arthurkowskii/AMEN_MINI/hardware/models/TeensyAudioBoard.step

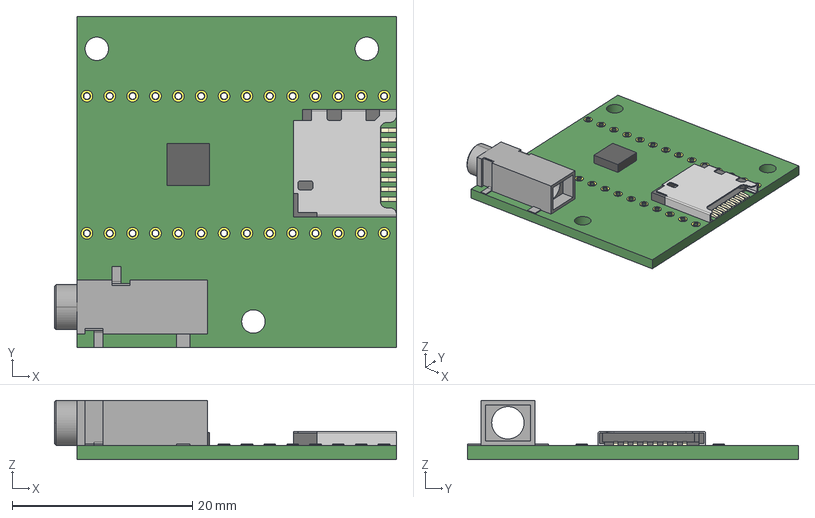
[picture p6: CAD file, 2026-08-08]
hardware/models/TeensyAudioBoard.step
38.0 x 36.8 x 6.60 mm
CUI_DEVICES_SJ-3523-SMT-TR
Base
Case
