arthurkowskii/AMEN_MINI/output/pcb-renders/AMEN_MINI-assembled-concept.png

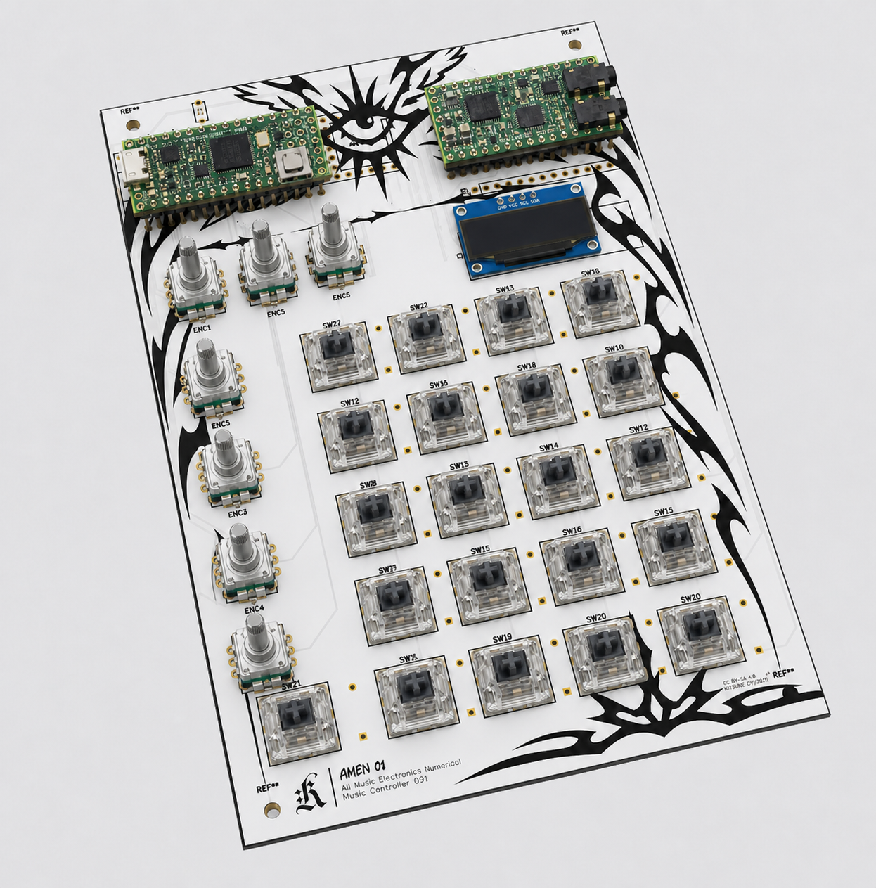
output/pcb-renders/AMEN_MINI-assembled-concept.png
