arthurkowskii/AMEN_MINI/hardware/AMEN_MINI.kicad_pcb

## KiCad design hardware/AMEN_MINI.kicad_pcb (2026-08-09)

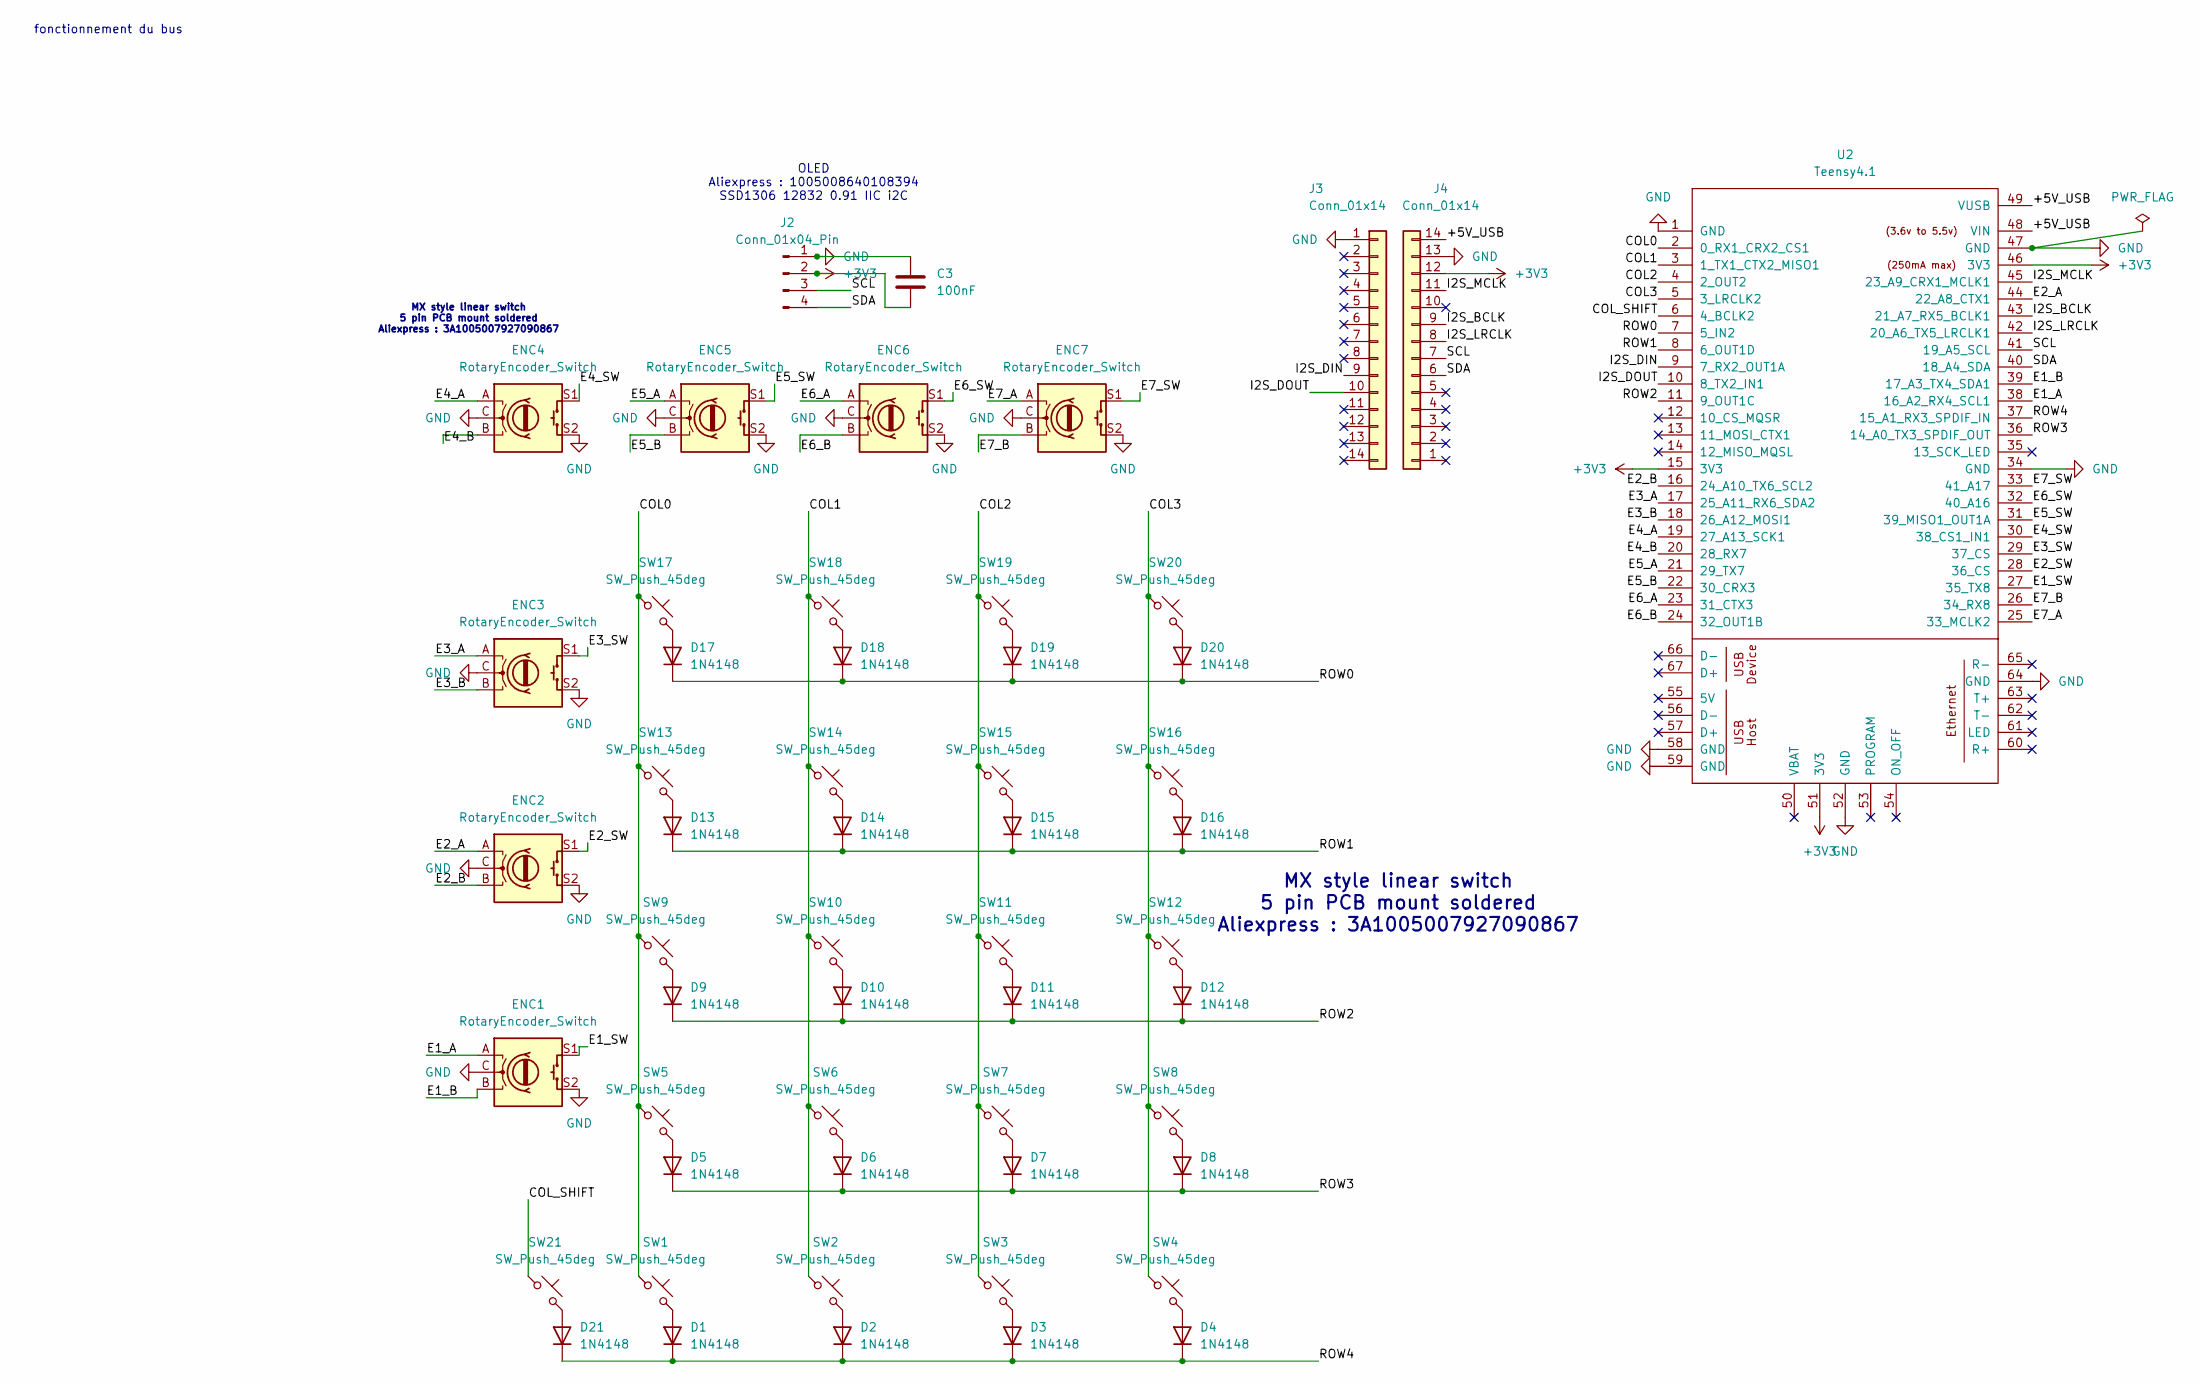
[picture p8: schematic AMEN_MINI.kicad_sch, AKOR_01_SCH]

Parts:
C3: 100nF; C_Disc_D5.0mm_W2.5mm_P5.00mm
D1, D2, D3, D4, D5, D6, D7, D8, D9, D10, D11, D12, D13, D14, D15, D16, D17, D18, D19, D20, D21: 1N4148; D_DO-35_SOD27_P10.16mm_Horizontal
ENC1, ENC2, ENC3, ENC4, ENC5, ENC6, ENC7: RotaryEncoder_Switch; RotaryEncoder_Alps_EC11E-Switch_Vertical_H20mm
J2: Conn_01x04_Pin; ER_OLEDM0.91_1x-I2C
J3, J4: Conn_01x14; PinHeader_1x14_P2.54mm_Vertical
SW1, SW2, SW3, SW4, SW5, SW6, SW7, SW8, SW9, SW10, SW11, SW12, SW13, SW14, SW15, SW16, SW17, SW18, SW19, SW20, SW21: SW_Push_45deg; SW_Cherry_MX_1.00u_PCB
U2: Teensy4.1; Teensy41

Connections:
+3V3: C3.2, J2.2, J4.12, U2.15 (3V3), U2.46 (3V3), U2.51 (3V3)
/+5V_USB: J4.14, U2.48 (VIN), U2.49 (VUSB)
/COL0: SW1.1, SW5.1, SW9.1, SW13.1, SW17.1, U2.2 (0_RX1_CRX2_CS1)
/COL1: SW2.1, SW6.1, SW10.1, SW14.1, SW18.1, U2.3 (1_TX1_CTX2_MISO1)
/COL2: SW3.1, SW7.1, SW11.1, SW15.1, SW19.1, U2.4 (2_OUT2)
/COL3: SW4.1, SW8.1, SW12.1, SW16.1, SW20.1, U2.5 (3_LRCLK2)
/COL_SHIFT: SW21.1, U2.6 (4_BCLK2)
/E1_A: ENC1.A, U2.38 (16_A2_RX4_SCL1)
/E1_B: ENC1.B, U2.39 (17_A3_TX4_SDA1)
/E1_SW: ENC1.S1, U2.27 (35_TX8)
/E2_A: ENC2.A, U2.44 (22_A8_CTX1)
/E2_B: ENC2.B, U2.16 (24_A10_TX6_SCL2)
/E2_SW: ENC2.S1, U2.28 (36_CS)
/E3_A: ENC3.A, U2.17 (25_A11_RX6_SDA2)
/E3_B: ENC3.B, U2.18 (26_A12_MOSI1)
/E3_SW: ENC3.S1, U2.29 (37_CS)
/E4_A: ENC4.A, U2.19 (27_A13_SCK1)
/E4_B: ENC4.B, U2.20 (28_RX7)
/E4_SW: ENC4.S1, U2.30 (38_CS1_IN1)
/E5_A: ENC5.A, U2.21 (29_TX7)
/E5_B: ENC5.B, U2.22 (30_CRX3)
/E5_SW: ENC5.S1, U2.31 (39_MISO1_OUT1A)
/E6_A: ENC6.A, U2.23 (31_CTX3)
/E6_B: ENC6.B, U2.24 (32_OUT1B)
/E6_SW: ENC6.S1, U2.32 (40_A16)
/E7_A: ENC7.A, U2.25 (33_MCLK2)
/E7_B: ENC7.B, U2.26 (34_RX8)
/E7_SW: ENC7.S1, U2.33 (41_A17)
/I2S_BCLK: J4.9, U2.43 (21_A7_RX5_BCLK1)
/I2S_DIN: J3.9, U2.9 (7_RX2_OUT1A)
/I2S_DOUT: J3.10, U2.10 (8_TX2_IN1)
/I2S_LRCLK: J4.8, U2.42 (20_A6_TX5_LRCLK1)
/I2S_MCLK: J4.11, U2.45 (23_A9_CRX1_MCLK1)
/ROW0: D17.1 (K), D18.1 (K), D19.1 (K), D20.1 (K), U2.7 (5_IN2)
/ROW1: D13.1 (K), D14.1 (K), D15.1 (K), D16.1 (K), U2.8 (6_OUT1D)
/ROW2: D9.1 (K), D10.1 (K), D11.1 (K), D12.1 (K), U2.11 (9_OUT1C)
/ROW3: D5.1 (K), D6.1 (K), D7.1 (K), D8.1 (K), U2.36 (14_A0_TX3_SPDIF_OUT)
/ROW4: D1.1 (K), D2.1 (K), D3.1 (K), D4.1 (K), D21.1 (K), U2.37 (15_A1_RX3_SPDIF_IN)
/SCL: J2.3, J4.7, U2.41 (19_A5_SCL)
/SDA: J2.4, J4.6, U2.40 (18_A4_SDA)
GND: C3.1, ENC1.C, ENC1.S2, ENC2.C, ENC2.S2, ENC3.C, ENC3.S2, ENC4.C, ENC4.S2, ENC5.C, ENC5.S2, ENC6.C, ENC6.S2, ENC7.C, ENC7.S2, J2.1, J3.1, J4.13, U2.1 (GND), U2.34 (GND), U2.47 (GND), U2.52 (GND), U2.58 (GND), U2.59 (GND), U2.64 (GND)
unnamed: D1.2 (A), SW1.2
unnamed: D2.2 (A), SW2.2
unnamed: D3.2 (A), SW3.2
unnamed: D4.2 (A), SW4.2
unnamed: D5.2 (A), SW5.2
unnamed: D6.2 (A), SW6.2
unnamed: D7.2 (A), SW7.2
unnamed: D8.2 (A), SW8.2
unnamed: D9.2 (A), SW9.2
unnamed: D10.2 (A), SW10.2
unnamed: D11.2 (A), SW11.2
unnamed: D12.2 (A), SW12.2
unnamed: D13.2 (A), SW13.2
unnamed: D14.2 (A), SW14.2
unnamed: D15.2 (A), SW15.2
unnamed: D16.2 (A), SW16.2
unnamed: D17.2 (A), SW17.2
unnamed: D18.2 (A), SW18.2
unnamed: D19.2 (A), SW19.2
unnamed: D20.2 (A), SW20.2
unnamed: D21.2 (A), SW21.2

Notes on the sheet:
MX style linear switch 5 pin PCB mount soldered Aliexpress : 3A1005007927090867
fonctionnement du bus
OLED Aliexpress : 1005008640108394 SSD1306 12832 0.91 IIC i2C

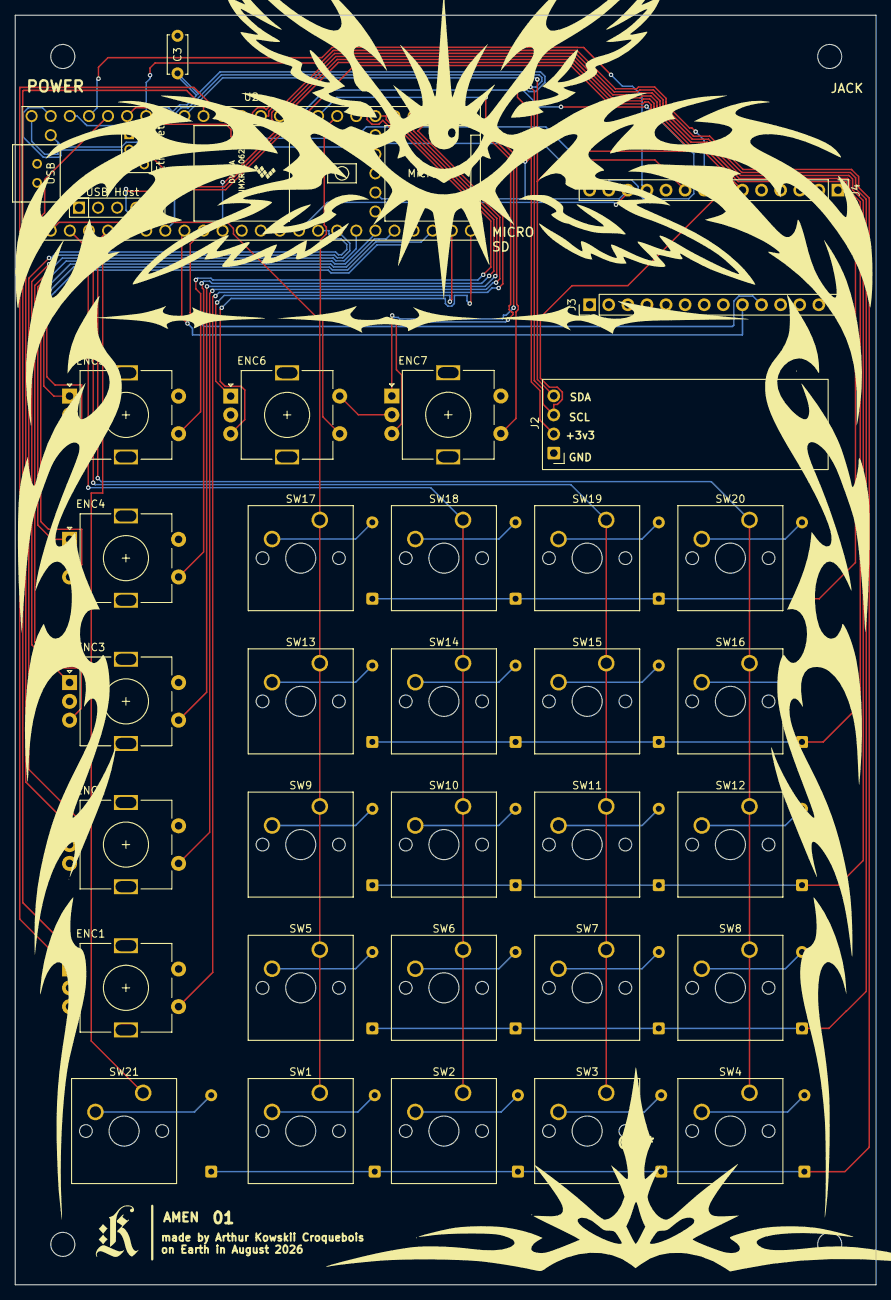
[picture p9: board AMEN_MINI.kicad_pcb from above]

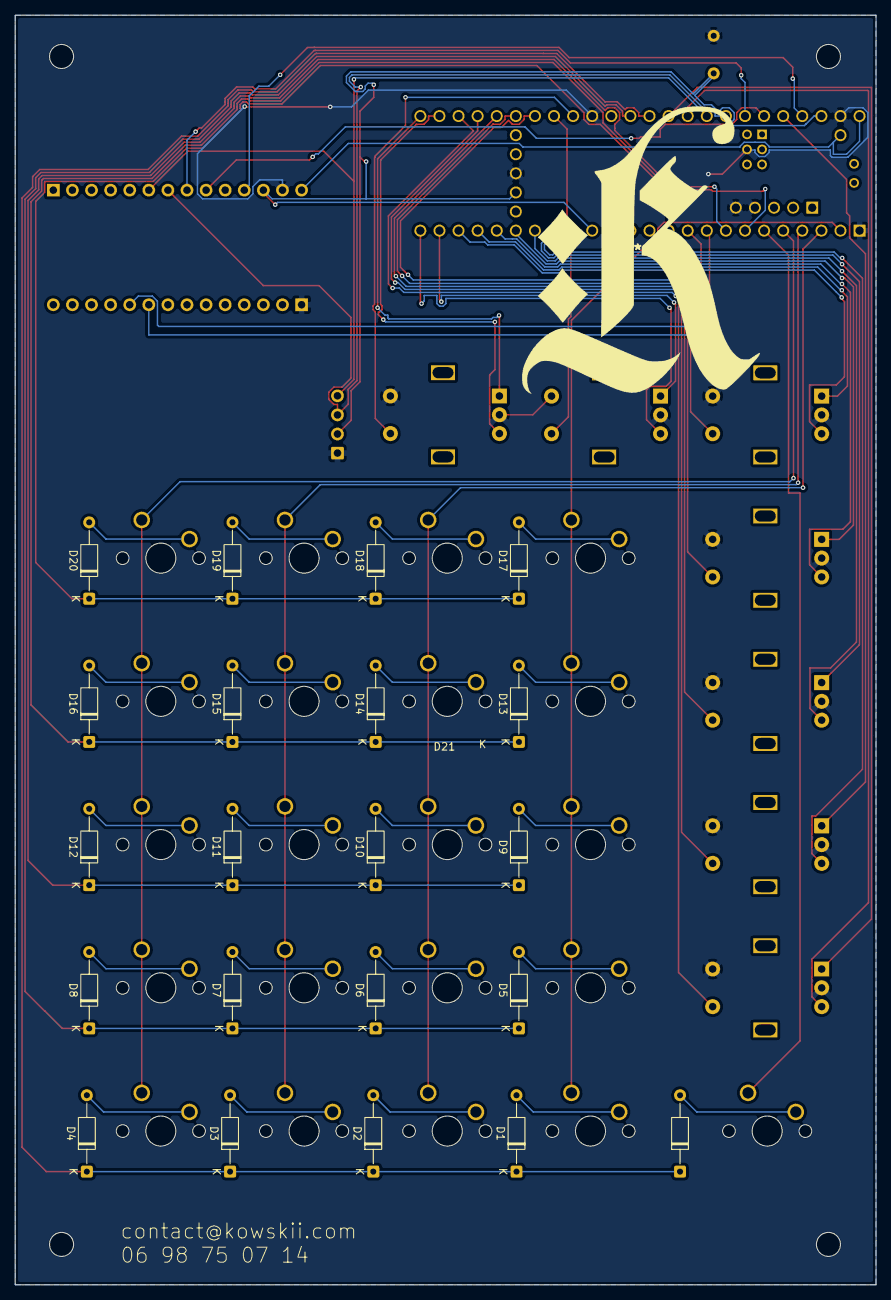
[picture p10: board AMEN_MINI.kicad_pcb from below]

Board: 2 copper layers, 114.5 x 168.9 mm, 54 parts (21 on the bottom side), 62 nets.
