arthurkowskii/AMEN_MINI/(commit log)

2026-08-08 feat: migrate AKOR hardware to AMEN_MINI
    [AKOR_01.kicad_pcb, AKOR_01.kicad_sch, AMEN_MINI.kicad_pcb, AMEN_MINI.kicad_sch, Cherry MX.STEP, TeensyAudioBoard.step]
2026-08-08 Pre DRC connections
    [AMEN_MINI.kicad_pcb]
2026-08-09 post DRC linking, 0 errors
    [AMEN_MINI.kicad_pcb]
2026-08-09 fix(pcb): improve I2S routing and ground continuity
    [AMEN_MINI.kicad_pcb]
2026-08-09 increasing gap between DIN & DOUT tracks
    [AMEN_MINI.kicad_pcb]
2026-08-09 dont remember what I did here
    [AMEN_MINI.kicad_pcb]
2026-08-11 docs(bom): add BOM_AMEN_MINI.csv (Teensy 4.1 + Audio Adapter SGTL5000 build)
    [BOM_AMEN_MINI.csv]
2026-08-11 docs(bom): Teensy 4.1 Lextronic with connectors + 2x sockets 1x24 (footprint verified)
    [BOM_AMEN_MINI.csv]
2026-08-15 J1: wav_loader PCM 16-bit + test roundtrip (marche de chunks)
2026-08-15 J2: player temps reel PC (miniaudio) + clavier, prets pour le SamplePlayer
2026-08-15 linear interpolation in sample player
2026-08-15 docs: chapitre Goal (vision de fin) en tête de roadmap
2026-08-16 feat: add sample browser foundation
2026-08-16 docs: clarify Teensy browser handoff
2026-08-16 feat: add live sampler speed control
2026-08-16 feat: simulate front-panel pads, fx pads and encoders
2026-08-16 feat: target held pad for speed and mode edit
    E4/E5 now edit the currently held voice pad instead of the last played pad. Each pad stores its own speed (25-400%) and playback mode, applied live with the existing 128-frame ramp (no retrigger). The SD browser opens via E1 while a pad is held; releasing retargets to the most recent still-held pad. Without a held pad, E4/E5 show a hint and do nothing.
2026-08-16 feat: triplet repeat divisions (1/12, 1/24)
    E3 now cycles Quarter, Eighth, EighthTriplet, Sixteenth, SixteenthTriplet, ThirtySecond. New enum values use scale x2/3 of their straight base (eighth triplet = 1/3 beat, sixteenth triplet = 1/6). requiredBufferFrames unchanged: worst case remains 1/4 at 20 BPM. Live division changes keep the existing 128-frame crossfade. Engine test covers 33/17 frame loops at 60 BPM. Docs and controls updated.
2026-08-16 feat: post-review plan, teensy layer bootstrap, gitignore cleanup
    PLAN_REVIEW_AOUT_2026: decisions on interaction paradigm (mode=latch behavior), SD browser with horizontal scroll, voice steal crossfade (64 frames), OLED overlay persistence, abbreviated names, FX roadmap expanded (FILTER/DELAY/BITCRUSH/CHAOS), E6 proposed as LFO.
    Teensy bootstrap: firmware.ino entry point, PsramArena (extmem_malloc 8MB), TeensyWavReader (SD File wrapper), SampleLoader (SD->PSRAM decode with validation-before-stop).
    .gitignore: exclude *.o artifacts and test_native/samples.
2026-08-16 docs: add checkpoint 17/08 post-review + teensy bootstrap
    Checkpoint post-review (mode=latch, 64-frame voice crossfade, SD browser horizontal scroll, OLED overlay persistence, abbreviated names, FX roadmap extended, E6 proposed as LFO, OLED art confirmed). Teensy bootstrap: firmware.ino, PsramArena, TeensyWavReader, SampleLoader.
2026-08-16 docs: integrate post-review decisions into roadmap J-sections
    J3: 64-frame voice steal crossfade spec added. J4: reflects existing PsramArena/TeensyWavReader/SampleLoader. J7: mode=latch behavior spec (ONE SHOT auto/gate TBD, LOOP latch 2nd press stops). J10: FX list expanded to 8 slots, abbreviated division names (1/8T, 1/16T). J12: status updated to EN COURS with bootstrap delivered. J13: SD browser horizontal scroll spec, OLED overlay persistence, abbreviated names. Priorities: crossfade, reverse DSP, overlay persistence promoted to P1. New features: CHAOS confirmed as 8th FX slot, E6 proposed as LFO, FX roadmap extended (FILTER/DELAY/BITCRUSH).
2026-08-17 fix(teensy): make PSRAM SD bootstrap compile
    [firmware.ino]
2026-08-17 fix(teensy): reserve PSRAM allocator headroom
2026-08-17 feat(engine): crossfade stolen voices over 64 frames
2026-08-17 feat(firmware_midi): AMEN MIDI controller core
    Portable C++17 USB-MIDI controller for the AMEN_MINI PCB (Teensy 4.1).
    - 12 musical pads with stable degree geography and immutable snapshots
    - 9 chord shapes selectable via E5 (NOTE..THIRTEENTH)
    - 7 harmony presets with prepared deterministic voicings (incl. Cinematic, Dark, Debussy, Ambient prototypes)
    - bimanual note-first / FX-first engine, Gate/Latch arbitration with previous-FX resume
    - global HOLD via Shift double-click, Panic via Shift+E7 click
    - 8 assignable FX slots (Strum, Arp, Run Up/Down, Trance Gate, Note Repeat, Random, Velocity)
    - normal encoders drive the AMEN engine; Shift+E1..E7 drive external profiles (Serum, Pigments, Falcon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
2026-08-17 docs: capture sampler docs, AMEN MIDI plans and netlist
    - firmware sampler: README, engine README, CONCEPT doc, notion_concept script
    - hardware/AMEN_MINI.net: real netlist used to derive the Teensy pin map
    - .hermes/plans: AMEN_MINI day plan and AMEN MIDI design plans
    Excludes firmware/out.wav (test output artifact) and hardware/AMEN_MINI.d356
    (IPC-D-356 fab test export).
2026-08-17 test(engine): validate transients on authentic CC0 drum break
    Replace the synthetic periodic loop as the onset-quality fixture with an
    authentic CC0 drum loop recording (Bronxio 240098, see test_break_CREDITS.txt).
    On real material the detector anchors 11/11 boundaries on recorded onsets
    within 15 ms and shares 6/11 of the strongest onsets with an independent
    fixed-floor selector; the synthetic loop keeps a decode-path/structure test.
2026-08-17 feat(harness): wire long-press transient assignment
    Enter hold (600 ms) on a browser WAV opens the ALL PADS / TRANSIENT /
    CANCEL menu; a fresh Enter confirms TRANSIENT: the WAV is loaded, eleven
    internal boundaries are detected and the twelve-range plan is published
    atomically through AssignmentSession (stopAll before swap, failure leaves
    state and previous plan untouched). Backspace cancels without resetting the
    browser scroll timeline. Short presses keep whole-file loading and clear the
    plan. While a plan is active, voice pads 1-6 trigger their own range from
    the session-owned buffer; pads 7-12 receive ranges but stay unplayable in
    the PC harness (documented temporary reduction). Rebuilt a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
2026-08-17 feat(firmware_midi): Teensy 4.1 adapter + hardware validation checklist
    Physical wiring derived from hardware/AMEN_MINI.net + AMEN_MINI.kicad_sch:
    - matrix 5x4 + COL_SHIFT (SW1..SW21), pads SW1..SW12 bas, FX SW13..SW20 haut, Shift SW21
    - encoders ENC1..7 quadrature + clic, OLED SSD1306 I2C 18/19 (0x3C)
    - sketch teensy/amen_midi (main.cpp + TeensyPort) USB serialmidi
    - scripts/build_teensy.sh: arduino-cli + generate sketch/src copy with
    relative includes (prepare_sketch.py) because arduino-cli's library
    detection pass does not receive -I flags
    - firmware_midi/docs/HARDWARE_VALIDATION.md: full bring-up checklist
    (matrix, encoders, OLED, bimanual, Hold, Panic, latency, presets audit)
    - sc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
2026-08-17 fix(harness): close browser and align menu state after transient confirm
    Address the quality review of 7e56ec7:
    - on successful TRANSIENT confirm, browserActive is cleared so the next
    Enter can no longer be swallowed and reload the whole file over the plan;
    - failure paths no longer re-open a zombie menu: the state machine is
    already back in Browsing, so the browser stays open with an honest
    console error instead;
    - encoder arrows are blocked while the menu is shown and while an Enter
    press is in progress (no selection/target desync);
    - releasing the voice pad while the menu is open cancels the menu so the
    next Enter cannot invisibly confirm;
    - the menu now highlights TRANSIENT (th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
2026-08-17 feat(fx): add 8-band spectral gate V0
    Eight-band split built from a ladder of Linkwitz-Riley 2nd-order lowpasses
    whose successive differences telescope to an exactly flat reconstruction
    (band b = LP(b) - LP(b-1), high band = input - LP6). Each band follows a
    16-step pattern at 1/16 notes synced to the global BPM; opens/closes are
    smoothed by a per-sample one-pole (~5 ms) that runs permanently, so
    activation and step boundaries are click-free by construction. Fixed
    memory, no allocation, no blocking. Wired as the TRANCE GATE slot of the
    FX list (global chain: voices -> repeat -> gate), BPM applied in the audio
    callback. Tests: BPM period, band gain >= 30 dB attenuation, click bound,
    bypass bi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
2026-08-17 fix(harness): keep FX cycle within the assignable list
    The gate wiring bumped kFxCount to 4, which made the FX cycle modulo
    (kFxCount + 1) = 5 while kFxNames holds exactly 4 entries, allowing the
    candidate index 4 to read past the array. TRANCE GATE was already
    reachable in the cycle with kFxCount = 3, so the DSP only needed the
    kGateFx activation checks. Restore kFxCount = 3 and add a static_assert
    pinning the kFxNames length to kFxCount + 1 so this class of overflow
    cannot return.
2026-08-17 feat(fx): add spectral freeze V0
    Captures the amplitude spectrum of the mix's most recent 512 frames
    (512-point FFT, periodic Hann analysis window), discards phase, and
    resynthesizes a 512-periodic drone with deterministic LCG phases. The
    loop plays back circularly: seamless by construction, and the output's
    magnitude spectrum is exactly the captured one. Capture reads the ring
    BEFORE the current block is written, so the freeze holds the immediate
    past with no added latency. Activation and release go through a ~10 ms
    one-pole wet ramp (click-free), and while never activated the chain is
    bit-exact passthrough; after release, wet snaps to exactly zero and
    frozen state resets. No allocation in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
2026-08-17 feat(engine): add per-pad granular cloud (CLOUD mode)
    The assigned pad range becomes a grain cloud: grains of 30-150 ms born
    every ~22 ms (bounded density, max 8 simultaneous), positions and
    lengths from a per-pad deterministic LCG. Hann envelopes on both grain
    edges make births and deaths click-free; release (or second press in
    LATCH) stops the cloud with a ~10 ms fade. The PCM is borrowed, never
    copied, so the cloud reads the loaded WAV or the TRANSIENT plan range
    directly with fixed memory. E5 rotation now cycles ONE SHOT / LOOP /
    CLOUD; clouds render in the audio callback after the voices under the
    engine lock, before the global FX chain. Tests: sentinel bounds (never
    reads outside the r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
2026-08-17 feat(engine): add retrospective capture buffer for COMMIT
    Fixed ring of caller-provided stereo storage (PSRAM-ready, sized by
    requiredBufferFrames, 15 s default): record() never allocates and runs
    in the audio callback; extractWindow() freezes the last windowFrames in
    chronological order for the COMMIT control path. Saturation caps
    recordedFrames at capacity; wrap reads are validated byte-exact against
    the last N frames. Defensive: null pointers, non-positive sizes, zero
    capacity.
2026-08-17 fix(engine): close granular cloud borrow-lifetime and parity gaps
    Review (deleg_318b8544) found one critical and three important issues,
    all reproduced before the fix:
    - UAF: HarnessVoiceStopper and the browser-load swap destroyed the
    borrowed PCM while clouds still rendered it (ASan heap-use-after-free).
    Both paths now stop every cloud before the move.
    - Speed > 1 read past the assigned range end: grain source position is
    now clamped to the range; sentinel test covers 25%/100%/400% speeds.
    - LATCH parity: padDownAction now stops LOOP and CLOUD on second press,
    matching the voice path and the documented contract.
    - Orphaned cloud on mode rotation: set_pad_mode stops the pad's cloud o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
2026-08-17 feat(harness): wire COMMIT retrospective capture gesture
    The 'v' key (Shift+pad on the instrument) freezes the last 15 s of the
    post-FX global mix into a new 12-range assignment: extract the ring
    under the engine lock, convert float->int16 stereo on the control path
    (no allocation in the callback — the ring is static, PSRAM-ready),
    detect boundaries, and publish atomically through applyTransient so the
    previous material survives any failure. Exercised on the real Linux
    harness: 95256 frames captured, 12 ranges published. amen_rt.exe
    rebuilt (COMMIT strings present), smoke exits 0.
2026-08-18 feat(fx): slew partagé + REVERSE + mode SHEPARD sur REPEAT
    - RampGain : courbe de transition partagée (glissement linéaire réglable,
    128 frames par défaut = comportement historique préservé bit à bit).
    setSlewFrames() règle la durée, aucun état ne commute sec.
    - LiveRepeat : la rampe de mix passe sur RampGain (setSlewFrames exposé).
    - ReversePlayer (nouveau FX REVERSE) : fenêtre de 2 s capturée avant
    l'appui, lue à l'envers en boucle, lissage de couture symétrique et
    protection d'écrasement par gel (même architecture que LiveRepeat).
    - SHEPARD (nouveau mode RepeatMode) : la position de lecture accélère
    linéairement (1x -> 1+depth sur 4 boucles) puis retombe —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
2026-08-18 feat(fx): PHASE DIST — allpass à coefficient variable (FX assignable)
    - Allpass du premier ordre : y = c*x + x[n-1] - c*y[n-1], c = 0.95 *
    amount * modulateur, clamp d'état anti-emballement (coefficient
    variable).
    - Modulateurs : SINE / SAW / SQUARE (LFO 0.1-20 Hz, défaut 1 Hz) et SELF
    (enveloppe peak-hold 50 ms du signal : le break plie sa propre phase,
    le squelchy Casio-CZ / piripiri).
    - keepBass : réinjection du dry filtré passe-bas (~120 Hz) dans le wet,
    les fondations survivent à la déformation.
    - Slew d'activation RampGain partagé ; inactif = passthrough bit-exact.
    - Tests : passthrough, silence, périodicité de régime permanent,
    stabilité sur entrée pleine é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
2026-08-18 feat(engine): GRANULAR — modes CLOUD/PITCH/RISE, pitch par grain, densité, interpolation
    - Le mode pad CLOUD devient GRANULAR ; CLOUD devient un mode de grains
    parmi trois (GrainMode) : Cloud (lecture naturelle, comportement
    historique byte-identique), Pitch (hauteur par grain tirée dans +/-
    0..24 st, tirages LCG conditionnés au mode : le déterminisme Cloud est
    préservé), Rise (glide par grain de -plage à +plage).
    - setPitchRangeSemitones (0..24), setDensity (0.25..4, cadence de spawn
    recalculée à chaque grain : réglage live), setGrainSizeScale (0.5..2).
    - Lecture interpolée linéairement : les hauteurs par grain restent
    propres, jamais de lecture hors plage même à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
2026-08-18 feat(harness+ui): câble REVERSE et PHASE DIST, E6 contextuel, rename CLOUD -> GRANULAR
    - Liste FX : BLANK/REPEAT/REVERSE/TRANCE GATE/FREEZE/PHASE DIST (kFxCount
    5, static_assert inchangée). REVERSE et PHASE DIST ont maintenant un DSP.
    - Chaîne FX : voix -> Repeat -> Reverse -> Phase Dist -> Gate -> Freeze.
    Slew de transition 15 ms (720 frames) sur Repeat/Reverse/Phase Dist.
    - E6 contextuel : pad voix GRANULAR tenu = cycle CLOUD/PITCH/RISE ; pad
    FX REPEAT tenu = LOOP/SHEPARD ; pad FX PHASE DIST tenu = cycle
    SINE/SAW/SQUARE/SELF ; sinon réserve LFO.
    - E2/E3 contextuels sur pad GRANULAR tenu : plage de hauteur +/- st
    (0..24) et densité (x0.25..x4). Les réglages vivent dans PadSe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
2026-08-19 feat(engine): PadRecorder — enregistrement mono par pad sans allocation
    - Shift+pad maintenu (J15) : le callback audio consigne le signal en mono
    (L+R)/2 dans le bloc statique du pad arme. Stockage fourni par l'appelant
    (contigu, kMaxPads blocs), zero allocation dans record(), PSRAM-ready.
    - arm(pad, sampleRate) demarre/redemarre (compteur a zero) ; un seul pad
    actif a la fois ; capacite atteinte = auto-stop sans debordement.
    - Conversion float->int16 arrondie au plus proche, symetrique, clamp
    [-1,1] prouve par test.
    - pcm(pad) -> PcmView emprunte (mono, channels=1) : la matiere du pad.
    Contrat de borrow documente (arm invalide la vue de CE pad seulement).
    - Tests : no-op au repo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
2026-08-19 test(engine): la matière enregistrée mono (PadRecorder) se joue sur les deux canaux
    - Forme exacte d'un PcmView sorti de PadRecorder::pcm (mono int16, 48 kHz) :
    trigger plein range, rendu au bon niveau, duplication L/R prouvée.
    - Complète la couverture existante (les fixtures voix étaient déjà mono) :
    le chemin enregistrement -> lecture est maintenant explicitement testé.
2026-08-19 feat(harness): Shift+pad = enregistrement direct du mix post-FX sur le pad (J15)
    - Windows : Shift gauche/droit + Numpad 1-6 = REC (press demarre, release du
    pad OU du Shift stoppe) ; le press est consomme (pas de trigger ni de
    cible encodeur pendant la prise). Linux : touche r sur le dernier pad.
    - Source = mix post-FX, meme point de prelevement que le ring COMMIT :
    on enregistre exactement ce qu'on entend. Capacite 6 s (kPadRecordSeconds),
    arret auto + message, overlay REC PAD n avec secondes ecoulees.
    - Source par pad persistante : la matiere enregistree prime sur le plan
    partage dans apply_pad_down_audio (voix ET granulaire, tous modes),
    survit a tout chargement WAV/TRANSIENT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
2026-08-19 docs: J15 — enregistrement direct par pad, du retrospectif au direct
    - CONTROLS : section Enregistrement direct (Shift + pad) — source post-FX
    sur PC / micro sur Teensy, 6 s, source par pad persistante, COMMIT
    retrospectif orthogonal (geste materiel a reassigner, candidat Shift+FX).
    - ROADMAP : J15 passe en V0 engine+harness livres (PadRecorder, tests,
    overlay, capacite), câblage Teensy documente (AudioInputI2S, SGTL5000
    MIC, matrice Shift, PSRAM 6,35 Mo pire cas) ; Skip Back : le geste
    Shift+pad voix est recode par J15 ; priorite P1 mise a jour.
    - CONCEPT : la ligne verrouillee 'pas d'enregistrement' est depassee par
    J15 (note explicite, decisions actees du 19/08).
2026-08-21 docs: licence CC BY-NC 4.0 — usage libre non-commercial, crédit si contenu publié en ligne
2026-09-06 fix(firmware_midi): make clockwise encoder turns increase values
    [amen_midi.ino]
2026-09-06 feat(firmware_midi): add NONE performance page as 20-note keyboard
    E3 now cycles HARMONY -> PATTERN -> NONE. In NONE the eight upper pads play
    the next eight scale degrees, turning the instrument into a 20-note
    consecutive keyboard; new presses are always single notes, even with a
    harmony slot held from HARMONY, and held roles keep their frozen contract.
    Leaving PATTERN into NONE cancels the active run like HARMONY does. Degree
    tables grow from 12 to 20 keys; the OLED shows the NONE tag and a three-way
    PAGE overlay.
2026-09-09 feat(audio): minimal 20-pad 4-voice SD sample player, retire old drafts
    Replace the PSRAM sampler and harmonic MIDI drafts (kept in Git history)
    with a minimal no-PSRAM WAV streamer: 20 assignable pads, 4 simultaneous
    PCM16/44100 voices, Shift+pad assignment browser, E1 navigate/confirm,
    E7 headphone volume from muted boot.
    Native engine tests, Windows listening harness with smoke check, Teensy
    build script. Bring-up diagnostics included; SGTL5000 stays silent on the
    assembled board (I2C phantoms dance, OLED writes now failing too) so the
    fault is electrical and under investigation.
    [amen_midi.ino, diatonic_scales.h, firmware.ino, gm_drum_kit.h, harmony_recipes.h]
2026-09-10 feat(midi): restore firmware, boot CHROMATIC preset on NONE page
    Restore firmware_midi as the flashed instrument firmware while the
    audio player is blocked on the codec hardware fault. Boot defaults
    change from MAJOR/HARMONY to CHROMATIC/NONE; native tests, Teensy
    build and docs updated to the new defaults.
2026-09-18 feat(midi): per-step velocity and per-pattern gate length
2026-09-18 feat(midi): add a global velocity ramp lane (build, hold, swell, fall)
2026-09-22 fix(midi): remove unstable DYNAMIC mode
    [amen_midi.ino, oled_ui.h, run_pattern.h, simple_midi_controller.h, test_main.cpp]
2026-10-02 [verified] feat: add E6 global velocity and move pattern assignment to E7
2026-10-05 fix: harmony overlay stayed in NONE mode
    [amen_midi.ino]
2026-10-05 velocity now moves per 3
2026-11-06 feat(midi): unify panel controls and add assignable CC multipliers
    Centralize encoder routing with contextual E1 pattern assignment, Shift priority, NOTES page, CC20-23 and independent X1/X2/X4/X8 steps.
    Cover routing and OLED regressions with strict native tests. Document the separately installed REAPER Windows hot-plug workaround and its user-confirmed reconnect test.
2026-11-06 fix(midi): default assignable encoder multipliers to x8
2026-11-07 feat(midi): add switchable horizontal performance layout
